remrc/3-Reaction-Wheels-Self-Balancing/pictures/3-wheel3.jpg

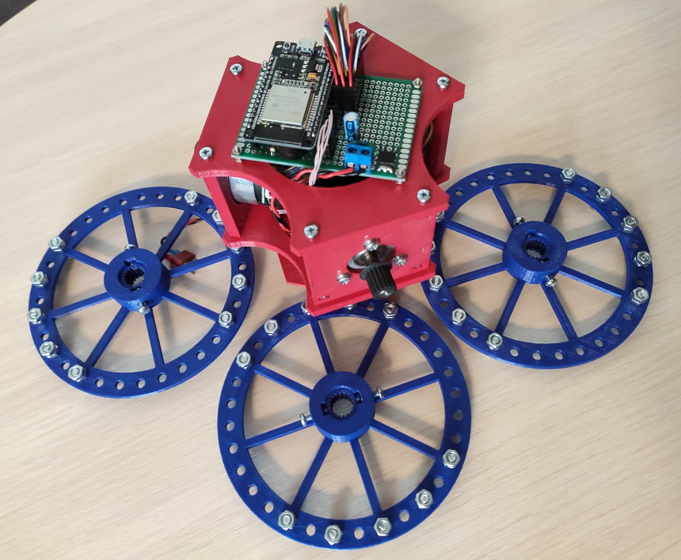
pictures/3-wheel3.jpg
